RFStateSide/RayCouplers/docs/images/README.md

# Historical RayCoupler Transformer Winding Experiments

File: raycoupler_toroid.png. Original RF StateSide photograph of physical toroidal
transformer samples constructed during development. ChatGPT was used only to crop the
photograph and clean up the background. The distributed edited file retains its AI media
credentials; those credentials do not establish that the underlying physical samples were
generated by AI. The file is not an unedited camera original. Exact original capture date
and originating webpage URL are not recorded.

The pictured samples may not represent the final winding counts or configurations used in
the released 200 W and 2 kW designs. The photograph does not establish final turn counts,
core counts or lead polarity.

SHA-256 of the unchanged distributed image: f48aae099b90ad16bf77364af2fc7fcb5c86f82d16ea9b410b5045cd0577d03d

Caption: Historical RayCoupler Transformer Winding Experiments. Original photograph by RF
StateSide LLC showing physical development samples; cropped and background-cleaned using
AI-assisted editing. Samples may differ from the final 200 W and 2 kW winding
configurations.
