RFStateSide/RayCouplers/docs/licensing.md

# Licensing

Copyright RF StateSide LLC. The original RayCouplers hardware contributions and
associated engineering source documentation are provided under CERN Open
Hardware Licence Version 2 — Permissive, SPDX **CERN-OHL-P-2.0**.

The unmodified [LICENSE](../LICENSE) contains the authoritative legal terms.
[NOTICE](../NOTICE) records project attribution and modifications. This document
explains their application; it does not replace or amend the license.

## Use, modification and distribution

The license permits use, copying, modification, manufacture and distribution
subject to its terms. Section 3 addresses source distribution: retain applicable
notices, and identify modifications with their date and a brief description.
Section 3.4 addresses distribution under different license terms, including
providing the CERN license. Section 4 requires product recipients to have access
to applicable notices.

Read the official text for the precise conditions and definitions. These
paragraphs do not introduce additional restrictions.

## Third-party material

Original RF StateSide contributions and upstream-derived material have distinct
rights. The mixed CAD collection includes standard KiCad-derived elements under
CC-BY-SA-4.0 with the KiCad library exception. Preserve the
[collection attribution](../hardware/libraries/README.md), upstream license and
exception. The project license does not grant rights to unrelated vendor assets
or third-party software.

Manufacturer datasheets and models are linked rather than bundled. See
[asset provenance](asset-provenance.md) for the material actually supplied.

## Engineering-reference status

RayCouplers is a **Public Engineering Reference — AS-IS**. No guaranteed RF power
handling, accuracy, fitness for a particular application or certification is
claimed. Builders must evaluate electrical, mechanical, thermal and RF behavior,
calibrate their systems and address applicable safety and regulatory requirements.

Section 5 of the official license contains warranty disclaimers and liability
provisions, subject to the limits stated there. Neither this explanation nor the
engineering-reference designation promises that every possible liability is
eliminated. See [known limitations](known-limitations.md).

## Official text and acquisition evidence

The license is copyright CERN 2020. The project copyright is recorded separately
in NOTICE. The text was obtained from the
[CERN/OHWR source](https://gitlab.com/ohwr/project/cernohl/-/raw/master/licence_texts/cern_ohl_p_v2.txt).
[license-provenance.json](license-provenance.json) records the URL, retrieval date,
size and SHA-256 of the acquired CRLF artifact. Git's LF representation differs
only in line endings; the complete legal text is retained.

The manufacturing package includes LICENSE and NOTICE. Library notices remain
in their source directory. Existing board artwork is retained; its presence does
not replace the source-distribution notices.
