RFStateSide/RayCouplers/bom/200w/RayCoupler-200w-population.csv

Variant | Category | References | Quantity | Value | Description | Footprint | Manufacturer | MPN | Supplier | Supplier_PN | Datasheet | Ratings | Population_notes | Sourcing_status
200w | Electrical | C1,C2,C8,C9 | 4 | .01 µF | 10 nF (0.01 uF), 200 V, X7R, 0805; candidate rating | Capacitor_SMD:C_0805_2012Metric_Pad1.18x1.45mm_HandSolder | Samsung Electro-Mechanics | CL21B103KDCNNNC | DigiKey |  | https://product.samsungsem.com/mlcc/CL21B103KDCNNN.do | 10 nF (0.01 uF), 200 V, X7R, 0805; candidate rating | Populate according to selected schematic; sourcing fields are candidates, not stock guarantees | Value supported; compatible candidate MPN; tested manufacturer unconfirmed
200w | Electrical | C3,C5,C6,C7 | 4 | .1 µF | CAP CER 0.1UF 50V X7R 0805 | Capacitor_SMD:C_0805_2012Metric_Pad1.18x1.45mm_HandSolder | Samsung | CL21B104KBCNFNC | DigiKey | 1276-2444-1-ND | https://product.samsungsem.com/mlcc/CL21B104KBCNFN.do | CAP CER 0.1UF 50V X7R 0805 | Populate according to selected schematic; sourcing fields are candidates, not stock guarantees | Historical sourcing candidate; supplier code/availability not verified
200w | Electrical | C4 | 1 | 22 pF | CAP CER 22PF 50V C0G/NP0 0805 | Capacitor_SMD:C_0805_2012Metric_Pad1.18x1.45mm_HandSolder | Samsung | CL21C220JBANFNC | DigiKey | 1276-2606-1-ND | https://product.samsungsem.com/mlcc/CL21C220JBANFN.do | CAP CER 22PF 50V C0G/NP0 0805 | Populate according to selected schematic; sourcing fields are candidates, not stock guarantees | Historical sourcing candidate; supplier code/availability not verified
200w | Electrical | D1,D2 | 2 | BAT42W | BAT42W Schottky detector; SOD-123; pin 1 K, pin 2 A | RayCouplers:D_SOD-123_handSoldering | Panjit International Inc. | BAT42W_R1_00001 | Digikey |  | https://www.panjit.com.tw/upload/datasheet/BAT42W_SERIES.pdf | 30 V, 200 mA candidate datasheet rating | Panjit SOD-123 candidate; pad 1 cathode, pad 2 anode; tested manufacturer unknown | Package-compatible proposed MPN; tested manufacturer unconfirmed
200w | Electrical | D3 | 1 | LED | Light emitting diode | LED_SMD:LED_0805_2012Metric_Pad1.15x1.40mm_HandSolder | Visual Communications Company - VCC | LSM0805412V | DigiKey | 28-LSM0805412VTR-ND | https://vcclite.com/wp-content/uploads/2019/05/LSM0805412V-Red-Datasheet.pdf | See cited datasheet; historical operating rating not independently verified | Populate according to selected schematic; sourcing fields are candidates, not stock guarantees | Historical sourcing candidate; supplier code/availability not verified
200w | Electrical | J1 | 1 | RF OUT | CONN UHF RCPT STR SOLDER | RayCouplers:RF_Pad_HF | Amphenol RF | 83-1R | Digikey | ARF1005-ND | https://www.amphenolrf.com/en-us/assets/file/4065788640/ | See cited datasheet; historical operating rating not independently verified | Populate according to selected schematic; sourcing fields are candidates, not stock guarantees | Historical sourcing candidate; supplier code/availability not verified
200w | Electrical | J2 | 1 | RF IN | CONN UHF RCPT STR SOLDER | RayCouplers:RF_Pad_HF | Amphenol RF | 83-1R | Digikey | ARF1005-ND | https://www.amphenolrf.com/en-us/assets/file/4065788640/ | See cited datasheet; historical operating rating not independently verified | Populate according to selected schematic; sourcing fields are candidates, not stock guarantees | Historical sourcing candidate; supplier code/availability not verified
200w | Electrical | J3 | 1 | Conn_Coaxial | coaxial connector (BNC, SMA, SMB, SMC, Cinch/RCA, LEMO, ...) | RayCouplers:RF_Pad_HF_Sm | Adam Tech | RF1-106-D-00-50-HDW | Digikey | 2057-RF1-106-D-00-50-HDW-ND | https://app.adam-tech.com/products/download/data_sheet/197859/rf1-106-d-00-50-hdw-data-sheet.pdf | See cited datasheet; historical operating rating not independently verified | Populate according to selected schematic; sourcing fields are candidates, not stock guarantees | Historical sourcing candidate; supplier code/availability not verified
200w | Electrical | J4 | 1 | Screw_Terminal_01x05 | 5-position terminal connector; existing 2.54 mm PCB land pattern; exact sourcing fit unresolved | TerminalBlock_Phoenix:TerminalBlock_Phoenix_MPT-0,5-5-2.54_1x05_P2.54mm_Horizontal |  |  | DigiKey |  |  | See cited datasheet; historical operating rating not independently verified | Populate according to selected schematic; sourcing fields are candidates, not stock guarantees | Connector sourcing and mechanical fit unresolved
200w | Electrical | J5 | 1 | Conn_Coaxial | coaxial connector (BNC, SMA, SMB, SMC, Cinch/RCA, LEMO, ...) | RayCouplers:RF_Pad_HF_Sm |  |  |  |  | ~ | See cited datasheet; historical operating rating not independently verified | Populate according to selected schematic; sourcing fields are candidates, not stock guarantees | Historical sourcing candidate; supplier code/availability not verified
200w | Electrical | JP1,JP2 | 2 | Jumper_3_Bridged12 | 3-pin 2.54 mm jumper header; separate removable shunt required | Connector_PinHeader_2.54mm:PinHeader_1x03_P2.54mm_Vertical |  |  | DigiKey |  |  | See cited datasheet; historical operating rating not independently verified | Header plus separate shunt; configure BOTH jumpers: 1-2 for SWR, 2-3 for power interrupt | Header MPN unresolved; historical STC02SYAN entry describes shunt
200w | Electrical | R1,R2,R4,R5 | 4 | 150 | Resistor 150 ohm; historical 1%, 1 W, 2512 specification | Resistor_SMD:R_2512_6332Metric_Pad1.40x3.35mm_HandSolder | Stackpole | RMCF2512FT150R | DigiKey | RMCF2512FT150RCT-ND | https://www.seielect.com/catalog/SEI-RMCF_RMCP.pdf | Resistor 150 ohm; historical 1%, 1 W, 2512 specification | Populate according to selected schematic; sourcing fields are candidates, not stock guarantees | Historical sourcing candidate; supplier code/availability not verified
200w | Electrical | R10,R16,R17 | 3 | 10K | Resistor 10K ohm; historical 1%, 1/8 W, 0805 specification | Resistor_SMD:R_0805_2012Metric_Pad1.20x1.40mm_HandSolder | Stackpole | RMCF0805FT10K0 | DigiKey | RMCF0805FT10K0CT-ND | https://www.seielect.com/catalog/sei-rmcf_rmcp.pdf | Resistor 10K ohm; historical 1%, 1/8 W, 0805 specification | Populate according to selected schematic; sourcing fields are candidates, not stock guarantees | Historical sourcing candidate; supplier code/availability not verified
200w | Electrical | R11,R7 | 2 | 3.3K | Resistor 3.3K ohm; historical 1%, 1/8 W, 0805 specification | Resistor_SMD:R_0805_2012Metric_Pad1.20x1.40mm_HandSolder | Stackpole | RMCF0805FT3K30 | DigiKey | RMCF0805FT3K30CT-ND | https://www.seielect.com/catalog/sei-rmcf_rmcp.pdf | Resistor 3.3K ohm; historical 1%, 1/8 W, 0805 specification | Populate according to selected schematic; sourcing fields are candidates, not stock guarantees | Historical sourcing candidate; supplier code/availability not verified
200w | Electrical | R12,R8 | 2 | 1.6K | Resistor 1.6K ohm; historical 1%, 1/8 W, 0805 specification | Resistor_SMD:R_0805_2012Metric_Pad1.20x1.40mm_HandSolder | Stackpole | RMCF0805FT1K60 | DigiKey | RMCF0805FT1K60CT-ND | https://www.seielect.com/catalog/sei-rmcf_rmcp.pdf | Resistor 1.6K ohm; historical 1%, 1/8 W, 0805 specification | Populate according to selected schematic; sourcing fields are candidates, not stock guarantees | Historical sourcing candidate; supplier code/availability not verified
200w | Electrical | R13 | 1 | 100K | Resistor 100K ohm; historical 1%, 1/8 W, 0805 specification | Resistor_SMD:R_0805_2012Metric_Pad1.20x1.40mm_HandSolder | Stackpole | RMCF0805FT100K | DigiKey | RMCF0805FT100KCT-ND | https://www.seielect.com/catalog/sei-rmcf_rmcp.pdf | Resistor 100K ohm; historical 1%, 1/8 W, 0805 specification | Populate according to selected schematic; sourcing fields are candidates, not stock guarantees | Historical sourcing candidate; supplier code/availability not verified
200w | Electrical | R14 | 1 | 470 | Resistor 470 ohm; historical 1%, 1/8 W, 0805 specification | Resistor_SMD:R_0805_2012Metric_Pad1.20x1.40mm_HandSolder | Stackpole | RMCF0805FT470R | DigiKey | RMCF0805FT470RTR-ND | https://www.seielect.com/catalog/sei-rmcf_rmcp.pdf | Resistor 470 ohm; historical 1%, 1/8 W, 0805 specification | Populate according to selected schematic; sourcing fields are candidates, not stock guarantees | Historical sourcing candidate; supplier code/availability not verified
200w | Electrical | R15,R19,R23,R25 | 4 | 2.7K | Resistor 2.7K ohm; historical 1%, 1/8 W, 0805 specification | Resistor_SMD:R_0805_2012Metric_Pad1.20x1.40mm_HandSolder | Stackpole | RMCF0805FT2K70 | DigiKey | RMCF0805FT2K70CT-ND | https://www.seielect.com/catalog/sei-rmcf_rmcp.pdf | Resistor 2.7K ohm; historical 1%, 1/8 W, 0805 specification | Populate according to selected schematic; sourcing fields are candidates, not stock guarantees | Historical sourcing candidate; supplier code/availability not verified
200w | Electrical | R20 | 1 | 68K | Resistor 68K ohm; historical 1%, 1/8 W, 0805 specification | Resistor_SMD:R_0805_2012Metric_Pad1.20x1.40mm_HandSolder | Stackpole | RMCF0805FT1M00 | DigiKey | RMCF0805FT1M00CT-ND | https://www.seielect.com/catalog/sei-rmcf_rmcp.pdf | Resistor 68K ohm; historical 1%, 1/8 W, 0805 specification | Populate according to selected schematic; sourcing fields are candidates, not stock guarantees | Historical sourcing candidate; supplier code/availability not verified
200w | Electrical | R21,R24 | 2 | 49.9 | Resistor 49.9 ohm; historical 1%, 1/8 W, 0805 specification | Resistor_SMD:R_0805_2012Metric_Pad1.20x1.40mm_HandSolder | Stackpole | RMCF0805FT47R0 | DigiKey | RMCF0805FT47R0TR-ND | https://www.seielect.com/catalog/sei-rmcf_rmcp.pdf | Resistor 49.9 ohm; historical 1%, 1/8 W, 0805 specification | Populate according to selected schematic; sourcing fields are candidates, not stock guarantees | Historical sourcing candidate; supplier code/availability not verified
200w | Electrical | R3,R6 | 2 | 56 | Resistor 56 ohm; historical 1%, 1 W, 2512 specification | Resistor_SMD:R_2512_6332Metric_Pad1.40x3.35mm_HandSolder | Stackpole | RMCF2512FT56R0 | DigiKey | RMCF2512FT56R0CT-ND | https://www.seielect.com/catalog/SEI-RMCF_RMCP.pdf | Resistor 56 ohm; historical 1%, 1 W, 2512 specification | Populate according to selected schematic; sourcing fields are candidates, not stock guarantees | Historical sourcing candidate; supplier code/availability not verified
200w | Electrical | R9 | 1 | 30K | Resistor 30K ohm; historical 1%, 1/8 W, 0805 specification | Resistor_SMD:R_0805_2012Metric_Pad1.20x1.40mm_HandSolder | Stackpole | RMCF0805FT30K0 | DigiKey | RMCF0805FT30K0CT-ND | https://www.seielect.com/catalog/sei-rmcf_rmcp.pdf | Resistor 30K ohm; historical 1%, 1/8 W, 0805 specification | Populate according to selected schematic; sourcing fields are candidates, not stock guarantees | Historical sourcing candidate; supplier code/availability not verified
200w | Transformer assembly | T1,T2 | 2 | 1:16T | Custom transformer assembly; 16 turns of 21 AWG high-temperature enameled copper wire; 1 Fair-Rite 5943001401 #43 core(s) | RayCouplers:SWRVoltageTransformer | RF StateSide LLC (custom assembly) |  |  |  | https://fair-rite.com/product/toroids-5943001401/ | See cited datasheet; historical operating rating not independently verified | Custom assembly: 16 turns, 1 Fair-Rite 5943001401 #43 core(s), 21 AWG high-temperature enameled copper wire; cores procured ONLY in Material rows; see construction document for unresolved lead mapping | Established core identity, turns and wire; physical lead/polarity mapping requires verification
200w | PCB feature | TP1 | 1 | SQ | test point | TestPoint:TestPoint_Pad_2.5x2.5mm |  |  |  |  | ~ | See cited datasheet; historical operating rating not independently verified | PCB test-point feature; no separately purchased component required | Historical sourcing candidate; supplier code/availability not verified
200w | PCB feature | TP2 | 1 | ÷4 | test point | TestPoint:TestPoint_Pad_2.5x2.5mm |  |  |  |  | ~ | See cited datasheet; historical operating rating not independently verified | PCB test-point feature; no separately purchased component required | Historical sourcing candidate; supplier code/availability not verified
200w | Electrical | U1 | 1 | MCP6561U | Single 1.8V Low-Power Push-Pull Output Comparator, SOT-23-5 | Package_TO_SOT_SMD:SOT-23-5_HandSoldering | Microchip | MCP6561UT-E/OT | DigiKey | MCP6561UT-E/OTCT-ND | http://ww1.microchip.com/downloads/en/DeviceDoc/MCP6561-1R-1U-2-4-1.8V-Low-Power-Push-Pull-Output-Comparator-DS20002139E.pdf | See cited datasheet; historical operating rating not independently verified | Populate according to selected schematic; sourcing fields are candidates, not stock guarantees | Historical sourcing candidate; supplier code/availability not verified
200w | Electrical | U20 | 1 | TLV3501AID | High-Speed Comparator, 4.5-ns, Rail-to-Rail, Push-Pull CMOS Output, SOIC-8 | Package_SO:SOIC-8_3.9x4.9mm_P1.27mm | Texas Instruments | TLV3501AID | DigiKey | 296-17921-5-ND | https://www.ti.com/lit/ds/symlink/tlv3501.pdf | See cited datasheet; historical operating rating not independently verified | Populate according to selected schematic; sourcing fields are candidates, not stock guarantees | Historical sourcing candidate; supplier code/availability not verified
200w | Electrical | U21 | 1 | MC74AC74DR2G | IC FF D-TYPE DOUBLE 1BIT 14SOIC | RayCouplers:SOIC127P600X175-14N | onsemi | MC74AC74DR2G | DigiKey | MC74AC74DR2GOSCT-ND | https://www.onsemi.com/pdf/datasheet/mc74ac74-d.pdf | See cited datasheet; historical operating rating not independently verified | Populate according to selected schematic; sourcing fields are candidates, not stock guarantees | Historical sourcing candidate; supplier code/availability not verified
200w | Electrical | VR1 | 1 | 10K | TRIMMER 10K OHM 0.5W PC PIN TOP | RayCouplers:TRIM_3296W1103LF | Bourns | 3296W-1-103LF | DigiKey | 3296W-103LF-ND | https://www.bourns.com/docs/product-datasheets/3296.pdf | See cited datasheet; historical operating rating not independently verified | Populate according to selected schematic; sourcing fields are candidates, not stock guarantees | Historical sourcing candidate; supplier code/availability not verified
200w | Mechanical | H1,H2,H3,H4 | 4 | 3.2 mm grounded mounting holes | Plated board features; retained copper pads |  |  |  |  |  |  |  | Do not purchase as separate electrical components | Existing PCB geometry verified
200w | Accessory | ASSY-SHUNTS | 2 | 2.54 mm removable shunt | One shunt for each JP1/JP2 header |  |  |  |  |  |  |  | Historical STC02SYAN is a sourcing lead only; verify fit | Mechanical fit and sourcing require verification
200w | Accessory | ASSY-FASTENERS | 4 | M3 mounting fastener positions | Fasteners matched to enclosure/stack height; exact hardware unresolved |  |  |  |  |  |  |  | Select fasteners/standoffs as needed for four holes; do not infer length/material | Mechanical fit and sourcing require verification
200w | Material | MAT-CORES | 2 | 43 toroid | Individual core; 25.4 mm OD x 15.5 mm ID x 8.15 mm height |  | Fair-Rite | 5943001401 | DigiKey / Mouser (historical) | Mouser 623-5943001401 | https://fair-rite.com/product/toroids-5943001401/ |  | Procure this quantity once for BOTH transformer assemblies; do not multiply by T1/T2 assembly quantities | Established core identity
200w | Material | MAT-WIRE |  | 21 AWG high-temperature enameled copper wire | For both T1/T2 windings; length, enamel class, temperature rating and supplier unspecified |  |  |  |  |  |  |  | Quantity as needed; established wire gauge and type only | Established wire gauge and type
200w | Material | MAT-TAPE |  | Insulating construction tape | Optional retention; exact historical material unspecified |  |  |  |  |  |  |  | Quantity as needed; manufacturer, thickness, adhesive and rating unspecified | Construction consumable specification unresolved
