RFStateSide/RayCouplers/bom/2kw/RayCoupler-2kw-population.csv

Variant | Category | References | Quantity | Value | Description | Footprint | Manufacturer | MPN | Supplier | Supplier_PN | Datasheet | Ratings | Population_notes | Sourcing_status
2kw | Electrical | C1,C2,C8,C9 | 4 | .01 µF | 10 nF (0.01 uF), 200 V, X7R, 0805; candidate rating | Capacitor_SMD:C_0805_2012Metric_Pad1.18x1.45mm_HandSolder | Samsung Electro-Mechanics | CL21B103KDCNNNC | DigiKey |  | https://product.samsungsem.com/mlcc/CL21B103KDCNNN.do | 10 nF (0.01 uF), 200 V, X7R, 0805; candidate rating | Populate according to selected schematic; sourcing fields are candidates, not stock guarantees | Value supported; compatible candidate MPN; tested manufacturer unconfirmed
2kw | Electrical | C3,C5,C6,C7 | 4 | .1 µF | CAP CER 0.1UF 50V X7R 0805 | Capacitor_SMD:C_0805_2012Metric_Pad1.18x1.45mm_HandSolder | Samsung | CL21B104KBCNFNC | DigiKey | 1276-2444-1-ND | https://product.samsungsem.com/mlcc/CL21B104KBCNFN.do | CAP CER 0.1UF 50V X7R 0805 | Populate according to selected schematic; sourcing fields are candidates, not stock guarantees | Historical sourcing candidate; supplier code/availability not verified
2kw | Electrical | C4 | 1 | 22 pF | CAP CER 22PF 50V C0G/NP0 0805 | Capacitor_SMD:C_0805_2012Metric_Pad1.18x1.45mm_HandSolder | Samsung | CL21C220JBANFNC | DigiKey | 1276-2606-1-ND | https://product.samsungsem.com/mlcc/CL21C220JBANFN.do | CAP CER 22PF 50V C0G/NP0 0805 | Populate according to selected schematic; sourcing fields are candidates, not stock guarantees | Historical sourcing candidate; supplier code/availability not verified
2kw | Electrical | D1,D2 | 2 | BAT42W | BAT42W Schottky detector; SOD-123; pin 1 K, pin 2 A | RayCouplers:D_SOD-123_handSoldering | Panjit International Inc. | BAT42W_R1_00001 | Digikey |  | https://www.panjit.com.tw/upload/datasheet/BAT42W_SERIES.pdf | 30 V, 200 mA candidate datasheet rating | Panjit SOD-123 candidate; pad 1 cathode, pad 2 anode; tested manufacturer unknown | Package-compatible proposed MPN; tested manufacturer unconfirmed
2kw | Electrical | D3 | 1 | LED | LED RED CLEAR 0805 SMD | LED_SMD:LED_0805_2012Metric_Pad1.15x1.40mm_HandSolder | Visual Communications Company - VCC | LSM0805412V | DigiKey | 28-LSM0805412VTR-ND | ~ | See cited datasheet; historical operating rating not independently verified | Populate according to selected schematic; sourcing fields are candidates, not stock guarantees | Historical sourcing candidate; supplier code/availability not verified
2kw | Electrical | J1 | 1 | RF OUT | coaxial connector (BNC, SMA, SMB, SMC, Cinch/RCA, LEMO, ...) | RayCouplers:RF_Pad_HF |  |  |  |  | ~ | See cited datasheet; historical operating rating not independently verified | Populate according to selected schematic; sourcing fields are candidates, not stock guarantees | Historical sourcing candidate; supplier code/availability not verified
2kw | Electrical | J2 | 1 | RF IN | coaxial connector (BNC, SMA, SMB, SMC, Cinch/RCA, LEMO, ...) | RayCouplers:RF_Pad_HF |  |  |  |  | ~ | See cited datasheet; historical operating rating not independently verified | Populate according to selected schematic; sourcing fields are candidates, not stock guarantees | Historical sourcing candidate; supplier code/availability not verified
2kw | Electrical | J3,J5 | 2 | Conn_Coaxial | coaxial connector (BNC, SMA, SMB, SMC, Cinch/RCA, LEMO, ...) | RayCouplers:RF_Pad_HF_Sm |  |  |  |  | ~ | See cited datasheet; historical operating rating not independently verified | Populate according to selected schematic; sourcing fields are candidates, not stock guarantees | Historical sourcing candidate; supplier code/availability not verified
2kw | Electrical | J4 | 1 | Screw_Terminal_01x05 | 5-position terminal connector; existing 2.54 mm PCB land pattern; exact sourcing fit unresolved | TerminalBlock_Phoenix:TerminalBlock_Phoenix_MPT-0,5-5-2.54_1x05_P2.54mm_Horizontal |  |  | DigiKey |  |  | See cited datasheet; historical operating rating not independently verified | Populate according to selected schematic; sourcing fields are candidates, not stock guarantees | Connector sourcing and mechanical fit unresolved
2kw | Electrical | JP1,JP2 | 2 | Jumper_3_Bridged12 | 3-pin 2.54 mm jumper header; separate removable shunt required | Connector_PinHeader_2.54mm:PinHeader_1x03_P2.54mm_Vertical |  |  | DigiKey |  |  | See cited datasheet; historical operating rating not independently verified | Header plus separate shunt; configure BOTH jumpers: 1-2 for SWR, 2-3 for power interrupt | Header MPN unresolved; historical STC02SYAN entry describes shunt
2kw | Electrical | R1,R2,R3,R4,R5,R6 | 6 | 100 | Resistor 100 ohm; historical 1%, 1 W, 2512 specification | Resistor_SMD:R_2512_6332Metric_Pad1.40x3.35mm_HandSolder | Stackpole |  | DigiKey |  | https://www.seielect.com/catalog/SEI-RMCF_RMCP.pdf | Resistor 100 ohm; historical 1%, 1 W, 2512 specification | Populate according to selected schematic; sourcing fields are candidates, not stock guarantees | 100 ohm population value; exact replacement MPN unresolved
2kw | Electrical | R10,R16,R17 | 3 | 10K | Resistor 10K ohm; historical 1%, 1/8 W, 0805 specification | Resistor_SMD:R_0805_2012Metric_Pad1.20x1.40mm_HandSolder | Stackpole | RMCF0805FT10K0 | DigiKey | RMCF0805FT10K0CT-ND | https://www.seielect.com/catalog/sei-rmcf_rmcp.pdf | Resistor 10K ohm; historical 1%, 1/8 W, 0805 specification | Populate according to selected schematic; sourcing fields are candidates, not stock guarantees | Historical sourcing candidate; supplier code/availability not verified
2kw | Electrical | R11,R7 | 2 | 3.9K | Resistor 3.9K ohm; historical 1%, 1/8 W, 0805 specification | Resistor_SMD:R_0805_2012Metric_Pad1.20x1.40mm_HandSolder | Stackpole | RMCF0805FT3K90 | DigiKey | RMCF0805FT3K90CT-ND | https://www.seielect.com/catalog/sei-rmcf_rmcp.pdf | Resistor 3.9K ohm; historical 1%, 1/8 W, 0805 specification | Populate according to selected schematic; sourcing fields are candidates, not stock guarantees | Historical sourcing candidate; supplier code/availability not verified
2kw | Electrical | R12,R8 | 2 | 1.2K | Resistor 1.2K ohm; historical 1%, 1/8 W, 0805 specification | Resistor_SMD:R_0805_2012Metric_Pad1.20x1.40mm_HandSolder | Stackpole | RMCF0805FT1K20 | DigiKey | RMCF0805FT1K20CT-ND | https://www.seielect.com/catalog/sei-rmcf_rmcp.pdf | Resistor 1.2K ohm; historical 1%, 1/8 W, 0805 specification | Populate according to selected schematic; sourcing fields are candidates, not stock guarantees | Historical sourcing candidate; supplier code/availability not verified
2kw | Electrical | R13 | 1 | 100K | Resistor 100K ohm; historical 1%, 1/8 W, 0805 specification | Resistor_SMD:R_0805_2012Metric_Pad1.20x1.40mm_HandSolder | Stackpole | RMCF0805FT100K | DigiKey | RMCF0805FT100KCT-ND | https://www.seielect.com/catalog/sei-rmcf_rmcp.pdf | Resistor 100K ohm; historical 1%, 1/8 W, 0805 specification | Populate according to selected schematic; sourcing fields are candidates, not stock guarantees | Historical sourcing candidate; supplier code/availability not verified
2kw | Electrical | R14 | 1 | 470 | Resistor 470 ohm; historical 1%, 1/8 W, 0805 specification | Resistor_SMD:R_0805_2012Metric_Pad1.20x1.40mm_HandSolder | Stackpole | RMCF0805FT470R | DigiKey | RMCF0805FT470RTR-ND | https://www.seielect.com/catalog/sei-rmcf_rmcp.pdf | Resistor 470 ohm; historical 1%, 1/8 W, 0805 specification | Populate according to selected schematic; sourcing fields are candidates, not stock guarantees | Historical sourcing candidate; supplier code/availability not verified
2kw | Electrical | R15,R19,R23,R25 | 4 | 2.7K | Resistor 2.7K ohm; historical 1%, 1/8 W, 0805 specification | Resistor_SMD:R_0805_2012Metric_Pad1.20x1.40mm_HandSolder | Stackpole | RMCF0805FT2K70 | DigiKey | RMCF0805FT2K70CT-ND | https://www.seielect.com/catalog/sei-rmcf_rmcp.pdf | Resistor 2.7K ohm; historical 1%, 1/8 W, 0805 specification | Populate according to selected schematic; sourcing fields are candidates, not stock guarantees | Historical sourcing candidate; supplier code/availability not verified
2kw | Electrical | R20 | 1 | 68K | Resistor 68K ohm; historical 1%, 1/8 W, 0805 specification | Resistor_SMD:R_0805_2012Metric_Pad1.20x1.40mm_HandSolder | Stackpole | RMCF0805FT68K0 | DigiKey | RMCF0805FT68K0CT-ND | https://www.seielect.com/catalog/sei-rmcf_rmcp.pdf | Resistor 68K ohm; historical 1%, 1/8 W, 0805 specification | Populate according to selected schematic; sourcing fields are candidates, not stock guarantees | Historical sourcing candidate; supplier code/availability not verified
2kw | Electrical | R21,R24 | 2 | 49.9 | Resistor 49.9 ohm; historical 1%, 1/8 W, 0805 specification | Resistor_SMD:R_0805_2012Metric_Pad1.20x1.40mm_HandSolder | Stackpole | RMCF0805FT49R9 | DigiKey | RMCF0805FT49R9TR-ND | https://www.seielect.com/catalog/sei-rmcf_rmcp.pdf | Resistor 49.9 ohm; historical 1%, 1/8 W, 0805 specification | Populate according to selected schematic; sourcing fields are candidates, not stock guarantees | Historical sourcing candidate; supplier code/availability not verified
2kw | Electrical | R9 | 1 | 30K | Resistor 30K ohm; historical 1%, 1/8 W, 0805 specification | Resistor_SMD:R_0805_2012Metric_Pad1.20x1.40mm_HandSolder | Stackpole | RMCF0805FT30K0 | DigiKey | RMCF0805FT30K0CT-ND | https://www.seielect.com/catalog/sei-rmcf_rmcp.pdf | Resistor 30K ohm; historical 1%, 1/8 W, 0805 specification | Populate according to selected schematic; sourcing fields are candidates, not stock guarantees | Historical sourcing candidate; supplier code/availability not verified
2kw | Transformer assembly | T1,T2 | 2 | 1:24T | Custom transformer assembly; 24 turns of 21 AWG high-temperature enameled copper wire; 2 Fair-Rite 5943001401 #43 core(s) | RayCouplers:SWRVoltageTransformer | RF StateSide LLC (custom assembly) |  |  |  | https://fair-rite.com/product/toroids-5943001401/ | See cited datasheet; historical operating rating not independently verified | Custom assembly: 24 turns, 2 Fair-Rite 5943001401 #43 core(s), 21 AWG high-temperature enameled copper wire; cores procured ONLY in Material rows; see construction document for unresolved lead mapping | Established core identity, turns and wire; physical lead/polarity mapping requires verification
2kw | PCB feature | TP1 | 1 | SQ | test point | TestPoint:TestPoint_Pad_2.5x2.5mm |  |  |  |  | ~ | See cited datasheet; historical operating rating not independently verified | PCB test-point feature; no separately purchased component required | Historical sourcing candidate; supplier code/availability not verified
2kw | PCB feature | TP2 | 1 | ÷4 | test point | TestPoint:TestPoint_Pad_2.5x2.5mm |  |  |  |  | ~ | See cited datasheet; historical operating rating not independently verified | PCB test-point feature; no separately purchased component required | Historical sourcing candidate; supplier code/availability not verified
2kw | Electrical | U1 | 1 | MCP6561U | Single 1.8V Low-Power Push-Pull Output Comparator, SOT-23-5 | Package_TO_SOT_SMD:SOT-23-5_HandSoldering | Microchip | MCP6561UT-E/OT | DigiKey | MCP6561UT-E/OTCT-ND | http://ww1.microchip.com/downloads/en/DeviceDoc/MCP6561-1R-1U-2-4-1.8V-Low-Power-Push-Pull-Output-Comparator-DS20002139E.pdf | See cited datasheet; historical operating rating not independently verified | Populate according to selected schematic; sourcing fields are candidates, not stock guarantees | Historical sourcing candidate; supplier code/availability not verified
2kw | Electrical | U20 | 1 | TLV3501AID | High-Speed Comparator, 4.5-ns, Rail-to-Rail, Push-Pull CMOS Output, SOIC-8 | Package_SO:SOIC-8_3.9x4.9mm_P1.27mm | Texas Instruments | TLV3501AID | DigiKey | 296-17921-5-ND | https://www.ti.com/lit/ds/symlink/tlv3501.pdf | See cited datasheet; historical operating rating not independently verified | Populate according to selected schematic; sourcing fields are candidates, not stock guarantees | Historical sourcing candidate; supplier code/availability not verified
2kw | Electrical | U21 | 1 | MC74AC74DR2G | IC FF D-TYPE DOUBLE 1BIT 14SOIC | RayCouplers:SOIC127P600X175-14N | onsemi | MC74AC74DR2G | DigiKey | MC74AC74DR2GOSCT-ND | https://www.onsemi.com/pdf/datasheet/mc74ac74-d.pdf | See cited datasheet; historical operating rating not independently verified | Populate according to selected schematic; sourcing fields are candidates, not stock guarantees | Historical sourcing candidate; supplier code/availability not verified
2kw | Electrical | VR1 | 1 | 10K | TRIMMER 10K OHM 0.5W PC PIN TOP | RayCouplers:TRIM_3296W1103LF | Bourns | 3296W-1-103LF | DigiKey | 3296W-103LF-ND | https://www.bourns.com/docs/product-datasheets/3296.pdf | See cited datasheet; historical operating rating not independently verified | Populate according to selected schematic; sourcing fields are candidates, not stock guarantees | Historical sourcing candidate; supplier code/availability not verified
2kw | Mechanical | H1,H2,H3,H4 | 4 | 3.2 mm grounded mounting holes | Plated board features; retained copper pads |  |  |  |  |  |  |  | Do not purchase as separate electrical components | Existing PCB geometry verified
2kw | Accessory | ASSY-SHUNTS | 2 | 2.54 mm removable shunt | One shunt for each JP1/JP2 header |  |  |  |  |  |  |  | Historical STC02SYAN is a sourcing lead only; verify fit | Mechanical fit and sourcing require verification
2kw | Accessory | ASSY-FASTENERS | 4 | M3 mounting fastener positions | Fasteners matched to enclosure/stack height; exact hardware unresolved |  |  |  |  |  |  |  | Select fasteners/standoffs as needed for four holes; do not infer length/material | Mechanical fit and sourcing require verification
2kw | Material | MAT-CORES | 4 | 43 toroid | Individual core; 25.4 mm OD x 15.5 mm ID x 8.15 mm height |  | Fair-Rite | 5943001401 | DigiKey / Mouser (historical) | Mouser 623-5943001401 | https://fair-rite.com/product/toroids-5943001401/ |  | Procure this quantity once for BOTH transformer assemblies; do not multiply by T1/T2 assembly quantities | Established core identity
2kw | Material | MAT-WIRE |  | 21 AWG high-temperature enameled copper wire | For both T1/T2 windings; length, enamel class, temperature rating and supplier unspecified |  |  |  |  |  |  |  | Quantity as needed; established wire gauge and type only | Established wire gauge and type
2kw | Material | MAT-TAPE |  | Insulating construction tape | For taped double-core preparation |  |  |  |  |  |  |  | Quantity as needed; manufacturer, thickness, adhesive and rating unspecified | Construction consumable specification unresolved
