RFStateSide/RayCouplers/calibration/reference/2kw-measured-forward.csv

Voltage_V | Power_W | Evidence | Source_workbook | Source_sheet | Voltage_cell | Power_cell
0.014 | 5.0 | historical measured forward | RayCoupler2000_WtoV.xlsx | Sheet1 | N4 | M4
0.052 | 10.0 | historical measured forward | RayCoupler2000_WtoV.xlsx | Sheet1 | N5 | M5
0.14 | 20.0 | historical measured forward | RayCoupler2000_WtoV.xlsx | Sheet1 | N6 | M6
0.195 | 30.0 | historical measured forward | RayCoupler2000_WtoV.xlsx | Sheet1 | N7 | M7
0.25 | 40.0 | historical measured forward | RayCoupler2000_WtoV.xlsx | Sheet1 | N8 | M8
0.285 | 50.0 | historical measured forward | RayCoupler2000_WtoV.xlsx | Sheet1 | N9 | M9
0.375 | 75.0 | historical measured forward | RayCoupler2000_WtoV.xlsx | Sheet1 | N10 | M10
0.445 | 100.0 | historical measured forward | RayCoupler2000_WtoV.xlsx | Sheet1 | N11 | M11
0.78 | 250.0 | historical measured forward | RayCoupler2000_WtoV.xlsx | Sheet1 | N12 | M12
1.18 | 500.0 | historical measured forward | RayCoupler2000_WtoV.xlsx | Sheet1 | N13 | M13
1.5 | 750.0 | historical measured forward | RayCoupler2000_WtoV.xlsx | Sheet1 | N14 | M14
1.76 | 1000.0 | historical measured forward | RayCoupler2000_WtoV.xlsx | Sheet1 | N15 | M15
1.95 | 1250.0 | historical measured forward | RayCoupler2000_WtoV.xlsx | Sheet1 | N16 | M16
2.175 | 1500.0 | historical measured forward | RayCoupler2000_WtoV.xlsx | Sheet1 | N17 | M17
