RFStateSide/RayCouplers/hardware/common/RayCouplers.kicad_pcb

## KiCad design hardware/common/RayCouplers.kicad_pcb (2026-10-10)

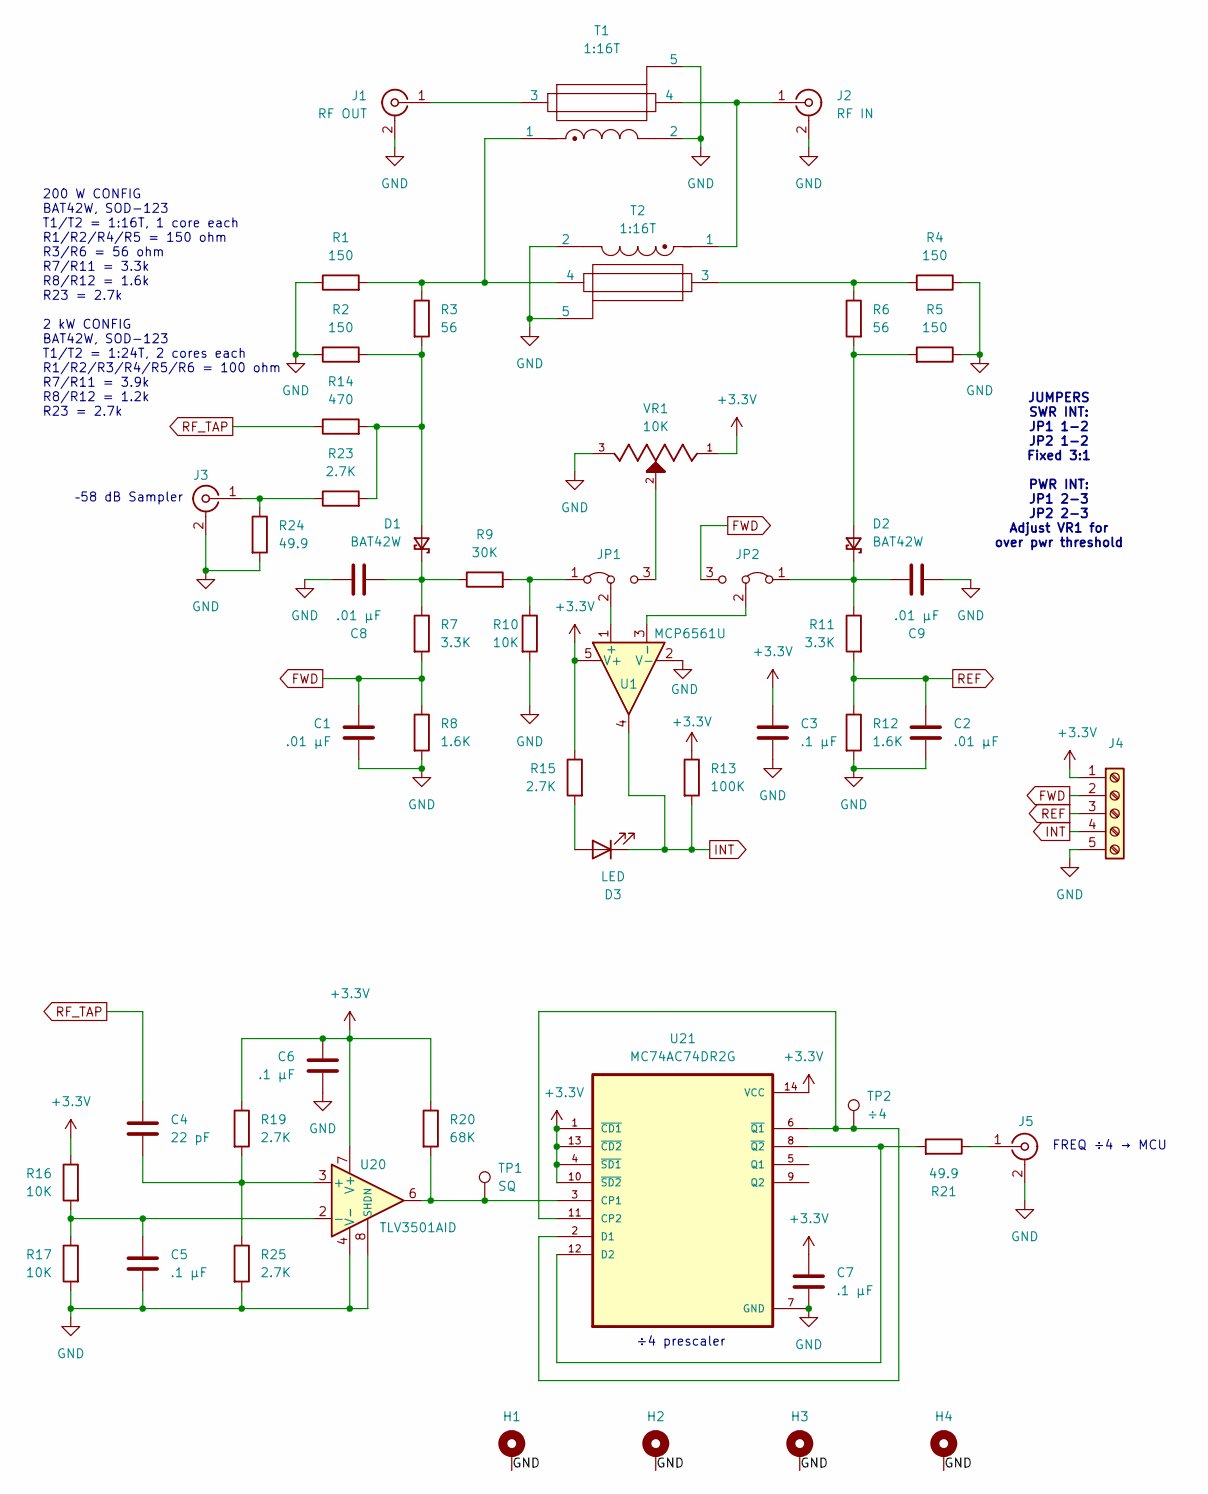
[picture p2: schematic RayCouplers.kicad_sch, RayCouplers - 200 W population]

Parts:
C1, C2, C8, C9: .01 µF; C_0805_2012Metric_Pad1.18x1.45mm_HandSolder; MPN CL21B103KDCNNNC
C3, C5, C6, C7: .1 µF; C_0805_2012Metric_Pad1.18x1.45mm_HandSolder; MPN CL21B104KBCNFNC
C4: 22 pF; C_0805_2012Metric_Pad1.18x1.45mm_HandSolder; MPN CL21C220JBANFNC
D1, D2: BAT42W; D_SOD-123_handSoldering; MPN BAT42W_R1_00001
D3: LED; LED_0805_2012Metric_Pad1.15x1.40mm_HandSolder; MPN LSM0805412V
H1, H2, H3, H4: MountingHole_Pad; MountingHole_3.2mm_M3_ISO7380_Pad_TopBottom_Gnd
J1: RF OUT; RF_Pad_HF; MPN 83-1R
J2: RF IN; RF_Pad_HF; MPN 83-1R
J3: Conn_Coaxial; RF_Pad_HF_Sm; MPN RF1-106-D-00-50-HDW
J4: Screw_Terminal_01x05; TerminalBlock_Phoenix_MPT-0,5-5-2.54_1x05_P2.54mm_Horizontal
J5: Conn_Coaxial; RF_Pad_HF_Sm
JP1, JP2: Jumper_3_Bridged12; PinHeader_1x03_P2.54mm_Vertical
R1, R2, R4, R5: 150; R_2512_6332Metric_Pad1.40x3.35mm_HandSolder; MPN RMCF2512FT150R
R3, R6: 56; R_2512_6332Metric_Pad1.40x3.35mm_HandSolder; MPN RMCF2512FT56R0
R7, R11: 3.3K; R_0805_2012Metric_Pad1.20x1.40mm_HandSolder; MPN RMCF0805FT3K30
R8, R12: 1.6K; R_0805_2012Metric_Pad1.20x1.40mm_HandSolder; MPN RMCF0805FT1K60
R9: 30K; R_0805_2012Metric_Pad1.20x1.40mm_HandSolder; MPN RMCF0805FT30K0
R10, R16, R17: 10K; R_0805_2012Metric_Pad1.20x1.40mm_HandSolder; MPN RMCF0805FT10K0
R13: 100K; R_0805_2012Metric_Pad1.20x1.40mm_HandSolder; MPN RMCF0805FT100K
R14: 470; R_0805_2012Metric_Pad1.20x1.40mm_HandSolder; MPN RMCF0805FT470R
R15, R19, R23, R25: 2.7K; R_0805_2012Metric_Pad1.20x1.40mm_HandSolder; MPN RMCF0805FT2K70
R20: 68K; R_0805_2012Metric_Pad1.20x1.40mm_HandSolder; MPN RMCF0805FT1M00
R21, R24: 49.9; R_0805_2012Metric_Pad1.20x1.40mm_HandSolder; MPN RMCF0805FT47R0
T1, T2: 1:16T; SWRVoltageTransformer
TP1: SQ; TestPoint_Pad_2.5x2.5mm
TP2: ÷4; TestPoint_Pad_2.5x2.5mm
U1: MCP6561U; SOT-23-5_HandSoldering; MPN MCP6561UT-E/OT
U20: TLV3501AID; SOIC-8_3.9x4.9mm_P1.27mm; MPN TLV3501AID
U21: MC74AC74DR2G; SOIC127P600X175-14N; MPN MC74AC74DR2G
VR1: 10K; TRIM_3296W1103LF; PARTREV 05/16

Connections:
+3.3V: C3.1, C6.1, C7.1, J4.1, R13.1, R15.1, R16.1, R19.1, R20.1, U1.5 (V+), U20.7 (V+), U21.1 (~CD1), U21.4 (~SD1), U21.10 (~SD2), U21.13 (~CD2), U21.14 (VCC), VR1.1
FWD: C1.1, J4.2, JP2.3 (B), R7.2, R8.1
GND: C1.2, C2.2, C3.2, C5.2, C6.2, C7.2, C8.2, C9.1, H1.1, H2.1, H3.1, H4.1, J1.2 (Ext), J2.2 (Ext), J3.2 (Ext), J4.5, J5.2 (Ext), R1.1, R2.1, R4.1, R5.1, R8.2, R10.2, R12.2, R17.2, R24.2, R25.2, T1.2, T1.5, T2.2, T2.5, U1.2 (V-), U20.4 (V-), U20.8 (SHDN), U21.7 (GND), VR1.3
INT: D3.1 (K), J4.4, R13.2, U1.4
unnamed: D1.2 (A), R2.2, R3.2, R14.2, R23.2
unnamed: C8.1, D1.1 (K), R7.1, R9.1
unnamed: D2.2 (A), R5.2, R6.2
unnamed: C9.2, D2.1 (K), JP2.1 (A), R11.1
unnamed: D3.2 (A), R15.2
unnamed: J1.1 (In), T1.3
unnamed: J2.1 (In), T1.4, T2.1
unnamed: J3.1 (In), R23.1, R24.1
unnamed: J5.1 (In), R21.1
unnamed: JP1.1 (A), R9.2, R10.1
unnamed: JP1.3 (B), VR1.2
unnamed: JP1.2 (C), U1.1 (+)
unnamed: JP2.2 (C), U1.3 (-)
unnamed: R1.2, R3.1, T1.1, T2.4
unnamed: R4.2, R6.1, T2.3
unnamed: C4.2, R19.2, R25.1, U20.3 (+)
unnamed: C5.1, R16.2, R17.1, U20.2 (-)
unnamed: R20.2, TP1.1, U20.6, U21.3 (CP1)
unnamed: TP2.1, U21.2 (D1), U21.6 (~Q1), U21.11 (CP2)
unnamed: R21.2, U21.8 (~Q2), U21.12 (D2)
REF: C2.1, J4.3, R11.2, R12.1
RF_TAP: C4.1, R14.1

Notes on the sheet:
–58 dB Sampler
JUMPERS SWR INT: JP1 1-2 JP2 1-2 Fixed 3:1 PWR INT: JP1 2-3 JP2 2-3 Adjust VR1 for over pwr threshold
÷4 prescaler
FREQ ÷4 → MCU
200 W CONFIG BAT42W, SOD-123 T1/T2 = 1:16T, 1 core each R1/R2/R4/R5 = 150 ohm R3/R6 = 56 ohm R7/R11 = 3.3k R8/R12 = 1.6k R23 = 2.7k 2 kW CONFIG BAT42W, SOD-123 T1/T2 = 1:24T, 2 cores each R1/R2/R3/R4/R5/R6 = 100 ohm R7/R11 = 3.9k R8/R12 = 1.2k R23 = 2.7k

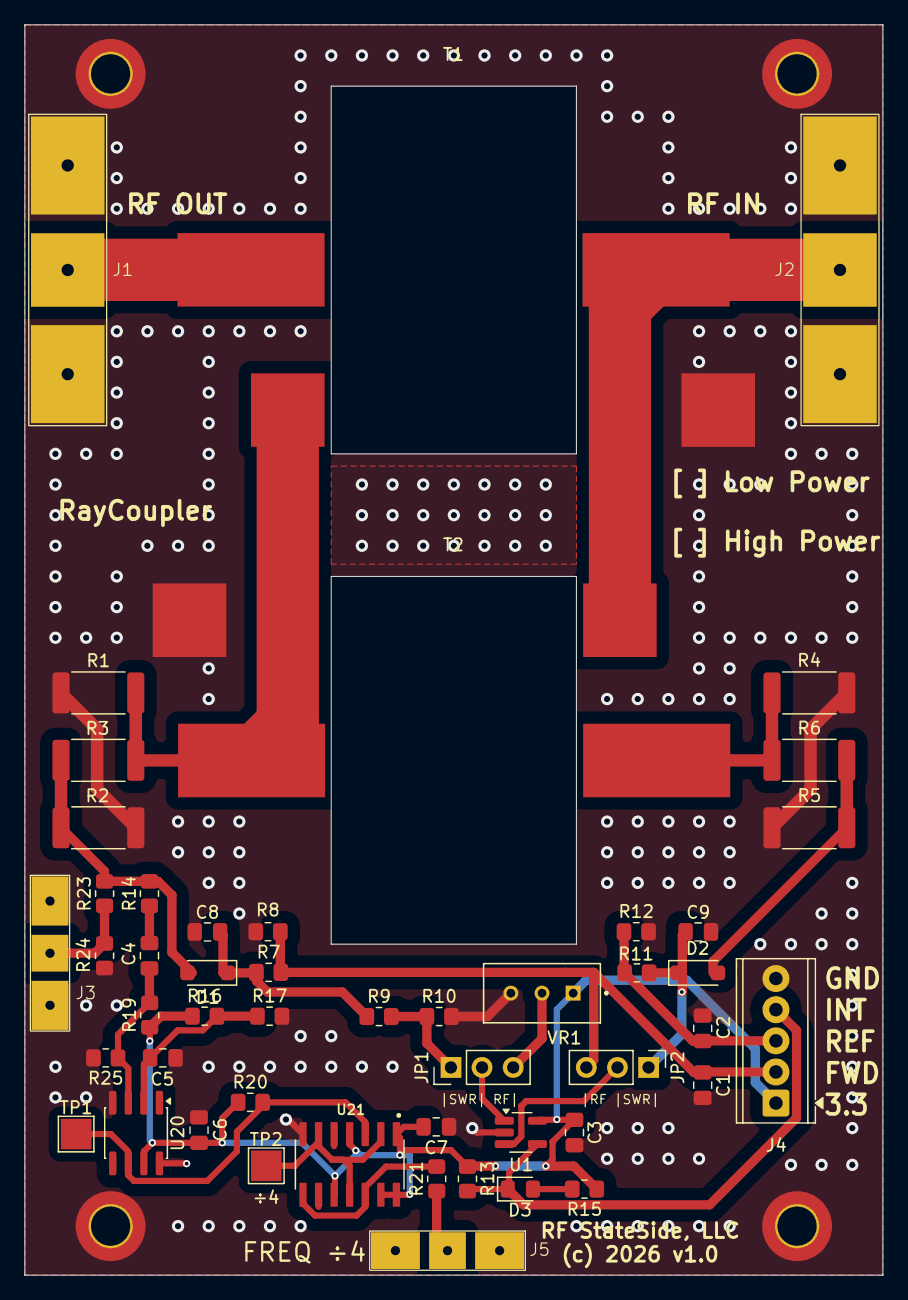
[picture p3: board RayCouplers.kicad_pcb from above]

Board: 2 copper layers, 70.0 x 102.0 mm, 54 parts (0 on the bottom side), 26 nets.
