RFStateSide/RayCouplers/(commit log)

2026-10-10 Initial RayCouplers engineering reference
    [200w-measured-forward.csv, 2kw-measured-forward.csv, RayCoupler-200w-population.csv, RayCoupler-2kw-population.csv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]
2026-10-11 RayCouplers: Final public-release preparation and distribution integrity
    [RayCouplers-B_Cu.gbr, RayCouplers-B_Mask.gbr, RayCouplers-B_Paste.gbr, RayCouplers-B_Silkscreen.gbr, RayCouplers-Edge_Cuts.gbr, RayCouplers-F_Cu.gbr, RayCouplers-F_Mask.gbr, RayCouplers-F_Paste.gbr]
2026-10-11 RayCouplers: Finalize public engineering reference documentation
    [RayCoupler-200w-population.csv, RayCoupler-2kw-population.csv, RayCouplers.kicad_sch, repository-inventory.csv]
