RFStateSide/RayCouplers/(notices)

Notices in the files:
hardware/common/RayCouplers.kicad_pcb:
CERN-OHL-P-2.0; see NOTICE and LICENSE
(c) 2026 v1.0
hardware/variants/2kw/RayCouplers.kicad_sch:
Copyright RF StateSide LLC | CERN-OHL-P-2.0; see NOTICE and LICENSE
